gabi200/canary-firmware/RPISoftware/README.md

# Canary 🐤

**Smart Building Safety & Hazard-Response Platform** for multi-unit residential buildings
(Romanian HOA / *asociații de proprietari* context).

Canary connects to an in-building IoT sensor network (combustible gas, CO, smoke /
particulates, water leak, and presence: radar on the real air sensor, Wi-Fi in the legacy
demo) and drives the safety-critical path:

> **detection → alert → evacuation → victim-accounting**

This directory is the **Raspberry Pi hub**: it receives MQTT from the real Canary
sensors (`../air_sensor` ESP32-S3, `../water_sensor` ESP32-C3), stores and analyses it,
and serves the web dashboard and the mobile app. It runs with one command
(`docker compose up -d`) on 64-bit Raspberry Pi OS, and simulators stand in for the
hardware when there is none. The architecture and delivery plan is
**[`ARCHITECTURE.md`](./ARCHITECTURE.md)**; its "As built" section says which parts of the
plan this hub implements. The firmware ↔ hub contract (MQTT topics, status documents,
analysis vocabulary, API) is **[`docs/HARDWARE.md`](./docs/HARDWARE.md)**. Checks and
troubleshooting: **[`DEBUG.md`](./DEBUG.md)**.

```
ESP32 air / water ──MQTT──▶ Mosquitto ──▶ backend (FastAPI)
  (per-device login)          (Pi)          ├─ raw status history + canonical readings
                                            ├─ detection → incidents → evacuation → accounting
                                            ├─ analysis per node / zone / building
                                            └─ REST + WebSocket
                            web dashboard ◀─┤  raw + analysis   (nginx, port 80)
                            mobile app    ◀─┘  analysis only    (port 80 or 8000)
```

---

## What's built

```
docker-compose.yml      mosquitto + backend + web (+ simulators in the "sim" profile); Pi-ready (arm64);
                        profile "cluster" adds etcd + Patroni Postgres + keepalived for the three-Pi mode
cluster/                three-Pi mode images (Patroni, keepalived) and the hailo-ollama unit for the AI HAT+ 2
mosquitto/config/       broker config: auth required, persistence, logs to stdout
                        (the password file is generated by scripts/pi_setup.sh, never committed)
scripts/pi_setup.sh     one-time setup: .env secrets, MQTT users per sensor, portal values to type
scripts/smoke.sh        backend tests + web typecheck/build + static infra checks (no Docker needed)
backend/                FastAPI service (SQLite on a volume by default, Postgres optional; no Redis)
  app/
    enums.py            canonical wire/DB/API vocabularies (single source of truth)
    config.py           env config (CANARY_*, docs/HARDWARE.md section 6)
    db.py               async SQLAlchemy; SQLite (WAL), or Postgres (+ Timescale hypertables if installed)
    models.py           data model (ARCHITECTURE.md §6) + hardware nodes / raw status history
    schemas.py          wire contracts (hardware status documents, canary.telemetry.v1) + API DTOs
    detection/          pure threshold + decision engine (§B, §7 guards)
    incidents/          pure state machine + orchestration service (§7)
    occupancy/          occupancy estimate + victim-accounting (§B)
    analytics/          node/zone/building analysis, triangulation, false-alarm reduction
    notify/             notification fan-out (stub: persists + WebSocket broadcast)
    ingestion/          pipeline, MQTT consumer, hardware status documents (hardware.py) (§5)
    retention.py        hourly: prunes raw status, readings, occupancy older than CANARY_RETENTION_DAYS
    realtime/           WebSocket connection manager (per-building rooms, time-boxed sends)
    api/                REST + WebSocket routes (§A.5)
    security.py         JWT auth + RBAC
    seed.py             demo building bld_007 (sensors, users, ARC)
    cluster.py          three-Pi mode: heartbeats, the processing lease, node-to-node calls
    ai/                 AI tasks (triangulation, signature shadow model, incident brief) and their offload
    main.py             app wiring + lifespan; keeps ?token= JWTs out of uvicorn's logs
  tests/                pure-logic + API/flow tests (95)
  Dockerfile            python:3.12-slim, deps from pyproject.toml, runs unprivileged
web/                    React + TS operations dashboard (raw + analysis)
  Dockerfile, nginx.conf  Vite build served by nginx, which proxies /api (+ WebSocket), /health, /docs
mobile/                 Flutter resident app (analysis only)
simulator/
  hw_sim.py             firmware-accurate air + water nodes (status documents, retained, last will, heartbeats)
  simulate.py           legacy canary.telemetry.v1 sensors of the demo building
docs/HARDWARE.md        the firmware ↔ hub contract
```

## Quickstart: Raspberry Pi (or any Docker host)

Full walk-through, including installing Docker and provisioning the ESP32 portals, in
**[`RUNME.md`](./RUNME.md) section 1**.

```bash
cd RPISoftware
scripts/pi_setup.sh air-kitchen water-kitchen   # .env secrets + one MQTT user per sensor;
                                                # prints what to type into each sensor's portal
docker compose up -d --build                    # Mosquitto :1883, backend :8000, dashboard :80
open http://<pi-ip>/                            # sign in as mihai

# no hardware? firmware-accurate simulated sensors:
docker compose --profile sim run --rm hw-sim --scenario co --fast
#   scenarios: normal | co | gas | smoke | leak | presence | offline | reboot | all
```

Watch live incidents over WebSocket (get a token first):

```bash
TOKEN=$(curl -s localhost:8000/api/v1/auth/token -H 'content-type: application/json' \
  -d '{"username":"mihai"}' | python3 -c 'import sys,json;print(json.load(sys.stdin)["access_token"])')

# any WS client, e.g. websocat:
websocat "ws://localhost:8000/api/v1/ws/incidents?building_id=bld_007&token=$TOKEN"
```

## One Pi or three

`CANARY_CLUSTER_MODE=single` (default) runs everything on one Pi, as above. `triple` spreads the
hub over three Pis that cover for each other (**[`RUNME.md`](./RUNME.md) section 3**):

| Pi | Runs | If it fails |
|---|---|---|
| `web` | the hub address (a floating IP): MQTT broker for the sensors, dashboard, API for the app | the address moves to `processing`, then `ai` |
| `processing` | MQTT subscription, detection, incidents, notifications, retention | `web` takes it over, then `ai` |
| `ai` | triangulation, the signature shadow model and incident briefs, the briefs on a Raspberry Pi AI HAT+ 2 (Hailo-10H, hailo-ollama) | the caller computes itself; briefs fall back to a template |

The three share one Postgres (Patroni: a primary and two replicas, one synchronous) and any one Pi
can fail; with two down the hub stops (no quorum) while the sensors keep alarming on their own.
`/admin/hub` in the dashboard shows which Pi runs what.

```bash
scripts/pi_setup.sh --cluster 192.168.1.10 192.168.1.11 192.168.1.12 192.168.1.13   # VIP, processing, web, ai
# copy .env and mosquitto/config/passwd to the other two Pis, run scripts/pi_setup.sh there, then on all three:
docker compose up -d --build
```

## Quickstart (no Docker — SQLite + HTTP ingest)

```bash
cd backend
python3 -m venv .venv && . .venv/bin/activate
pip install -e ".[dev]"
export CANARY_DATABASE_URL="sqlite+aiosqlite:///./canary.db"
export CANARY_MQTT_ENABLED=false
uvicorn app.main:app --reload
# then POST telemetry to /api/v1/telemetry (same pipeline as MQTT) — see tests for payloads
```

## Demo accounts (seeded, dev token by username)

| username | role | can |
|---|---|---|
| `ana` | resident | check in ("I'm safe"), see status |
| `mihai` | hoa_manager | dashboard, incidents, accounting, dismiss/evacuate/resolve |
| `dispecer` | dispatcher_external | incident-centric view, accounting |
| `tehnician` | technician | installs: floors, apartments, rooms, new sensors, alarm tests (no accounts, no incident actions) |
| `admin` | system_admin | everything |

The login is username-only: a known MVP limitation. Run the hub on a trusted LAN/VLAN
(RUNME §1.10).

## Key endpoints

| Method | Path | Role |
|---|---|---|
| POST | `/api/v1/auth/token` | public (dev) |
| GET | `/api/v1/buildings/{id}/summary` | any (analysis only: mobile + dashboard; residents get no occupancy) |
| GET | `/api/v1/buildings/{id}/nodes` | manager / dispatcher / admin (raw + analysis) |
| GET | `/api/v1/nodes/{node_id}/history?minutes=60&fields=a,b` | manager / dispatcher / admin |
| PATCH | `/api/v1/nodes/{node_id}` (`zone_id`, `name`) | manager / admin |
| GET | `/api/v1/buildings/{id}/incidents?active=true` | any |
| GET | `/api/v1/incidents/{id}/events` | any |
| GET | `/api/v1/incidents/{id}/accounting` | manager / dispatcher |
| GET | `/api/v1/incidents/{id}/brief` | manager / dispatcher (short responder brief: AI HAT+ 2 LLM, else a template) |
| GET | `/api/v1/cluster` | manager / technician / admin (which Pi runs what) |
| POST | `/api/v1/incidents/{id}/checkin` | resident |
| POST | `/api/v1/incidents/{id}/dismiss` \| `/order-evacuation` \| `/resolve` | manager / dispatcher |
| POST | `/api/v1/telemetry` | dev ingress, no auth (prod = MQTT) |
| WS | `/api/v1/ws/incidents?building_id=&token=` | authenticated |

`system_admin` passes every role check. REST timestamps are UTC with a `Z` suffix.
Payload shapes of the hardware endpoints: [`docs/HARDWARE.md`](./docs/HARDWARE.md) sections 3–5.
The safety rules applied to hardware readings (device thresholds only when sane, a
device's own alarm never downgraded, only the reporting device can clear its incident,
smoke never auto-evacuates) are in its section 2.

## Tests

```bash
bash scripts/smoke.sh                        # backend tests + web typecheck/build + static infra checks: SMOKE: PASS
cd backend && .venv/bin/python -m pytest -q  # 95 passed (smoke.sh creates .venv on its first run)
```

- `test_state_machine.py`, `test_detection.py` — pure logic, no DB (incl. insane device thresholds → defaults).
- `test_ingestion_dedupe.py` — `(device_id, epoch, seq)` dedupe + **reboot regression**.
- `test_incident_flow.py` — critical gas → `evacuation`, check-in → unaccounted count drops, RBAC,
  another device's normal readings never clear an incident, UTC timestamps on SQLite.
- `test_hardware_translation.py`, `test_environment_analysis.py` — status document → readings,
  and the analysis vocabulary (pure).
- `test_hardware_ingest.py` — the MQTT hardware path end to end: registration, retained/duplicate
  documents, reboots, availability, resident privacy, roles, history, retention, WebSocket
  fan-out, log redaction.

Mobile: `flutter analyze` and `flutter test` in `mobile/` ([`mobile/README.md`](./mobile/README.md)).

Agent-oriented checks and troubleshooting (including MQTT): [`DEBUG.md`](./DEBUG.md).

## Web — Operations dashboard (React)

`web/` — role-based console (React + TS + Vite): **Manager/HOA** view (floor plan, live
sensor status, an Environment card for the hardware nodes, trends, device health, incident
actions), **Dispatch/emergency-services** view (hazard source on floor plan, occupancy +
unaccounted count, evacuation progress, timeline) and **Sensors** view (`/sensors`: the
hub's analysis on top, then each ESP32 with its raw status grouped like the firmware, its
own thresholds, the verbatim JSON and raw history charts, 15 min–24 h). Live over
WebSocket. On the hub it is served by nginx on port 80, same origin as the API. See
[`web/README.md`](./web/README.md).

## Mobile — Flutter resident app

`mobile/` — resident app (Flutter): emergency alerts, evacuation guidance routed away
from the hazard, and "I'm safe" check-in feeding victim-accounting. Talks to the hub
over REST + WebSocket (`--dart-define=CANARY_API=http://<pi-ip>`) and shows the sensor
analysis only ("Home status" for residents, "Building sensors" for managers), never raw
sensor values. See [`mobile/README.md`](./mobile/README.md).

## AI hazard-source triangulation

`backend/app/analytics/` — estimates the leak origin from the sensor array
(concentration-weighted centroid + time-of-first-detection, optional airflow prior),
with an honest confidence score (capped at 0.95; single-sensor degrades to zone-level).
Runs from `verification` onward for gas/CO; exposed at
`GET /api/v1/incidents/{id}/triangulation` and surfaced on the dashboard floor plan
(SOURCE marker + confidence) and the Dispatch "Hazard source (AI)" card. The estimate
can differ from the first-detection zone (it follows the concentration peak).

## False-alarm reduction

`backend/app/analytics/false_alarm.py` — classifies a sensor's recent reading window
(spike-and-decay, oscillatory cooking, sensor drift, sustained-genuine, sub-threshold
micro-leak trend) and may **hold a corroborated-by-count, non-critical signal in
`verification`** instead of alarming — e.g. a lone sensor sitting flat just over
threshold. Real cross-sensor corroboration (a second device/zone) or a clearly rising
trend escalates as genuine. **Critical readings and edge alarms are never suppressed.**
Slow sub-threshold rises open a low-severity **advisory** incident (managers only).
Assessment shown on the dashboard (signal badge); rule-based now, same features feed
an ML upgrade later (ARCHITECTURE.md §B.3).

Air nodes are also labelled by the hazard signature classifier
(`backend/app/analytics/signature/`), which reads all of a node's channels together. A
confident steam, cooking or aerosol label may hold a corroborated **particulate**
escalation from a single sensor in `verification` (reason `held_signature_<label>`); a
fire label cancels any hold. Gas and CO, critical readings, node alarms and real
cross-sensor corroboration are never held by it. A shadow model's opinion is stored in
`signature_assessments` but never used.

## Known limitations

- Not yet validated on a physical Raspberry Pi with the real sensors: tests and the
  firmware-accurate simulator only.
- Username-only dashboard/app login and plaintext MQTT/HTTP: trusted LAN/VLAN only
  (RUNME §1.10).
- The demo building `bld_007` (zones, demo devices, users) is always seeded, and new
  sensors with a `demo-` MQTT base land in its `zone_hallway`; every other new sensor lands in
  `bld_live` / `zone_live`, until moved (`PATCH /api/v1/nodes/{id}`).
- One open incident per hazard type per building.
- The hub sends no commands to the devices yet (the firmware's valve/buzzer topics exist).
- No schema migrations: a Postgres database created by an earlier version needs one
  manual change (RUNME §1.9).

## Not yet built (see ARCHITECTURE.md roadmap §F)

TLS for MQTT/HTTP and real user authentication, real FCM/APNs delivery (wired but off
by default; needs Firebase config), hub → device commands, LoRa gateway tier,
tamper-evident audit hash-chaining, alembic migrations, external dispatch adapters. The
backend notification layer is a stub (persists + WebSocket broadcast); transports plug
in behind it. Occupancy/victim-accounting is basic (rule-based) — the ML upgrade paths
are described in ARCHITECTURE.md §B. What was built versus the plan: the "As built"
section at the top of [`ARCHITECTURE.md`](./ARCHITECTURE.md).

> ⚠️ MVP detection thresholds are illustrative engineering defaults, **not** certified
> life-safety setpoints. Canary is an advisory system in this slice — not a substitute
> for certified gas/CO alarms.
