gabi200/canary-firmware/HANDOFF.md

# Handoff: Evacuate screen redesign

Branch: `feat/evacuate-route-line` · Last updated: 2026-09-30

## Done

- **Backend.** `GET /buildings/{id}/evacuation` returns `waypoints` (`id`, `label`, `kind`, `hint`)
  with human-readable names, skips malformed path entries instead of failing, and orders
  routes deterministically. The seed route uses real Romanian names and hints.
  101 tests pass.
- **Mobile, Evacuate screen (model A, "route line").** `lib/src/ui/alarm_screen.dart`,
  `widgets/route_line.dart`:
  - hazard header with a Live/Offline chip; Minimize replaces the ✕
  - a "don't" line per hazard type (`logic/hazard_advice.dart`)
  - vertical route: Start here → steps with hints → assembly point, plus an "Avoid: <zone>" marker
  - a pinned action bar: I'm out and safe / I need help / Call 112 (`url_launcher`) /
    Safe but still inside; the check-in can be changed later
  - haptic pulse on open; the screen stays awake (`wakelock_plus`)
- **Mobile, route safety.** `logic/route_selection.dart` rates each route `clear`, `unknown` or
  `crosses` against every affected zone. The screen shows a red warning for `crosses` and an
  amber one for `unknown`. Parsing skips malformed routes and waypoints instead of dropping
  everything. 21 tests pass; `flutter analyze` reports no errors or warnings.
- Verified by hand on the Pixel 9 Pro XL emulator with a simulated gas leak.

## To do next

1. Widget tests and golden screenshots for the Evacuate screen: each hazard type,
   `crosses` / `unknown` warnings, offline chip, check-in → Change flow, 2× text scale.
2. Home screen shows raw IDs: `bld_007` in the app bar and `zone_kitchen` in the red
   EVACUATE banner (`home_screen.dart`, `flashing_evacuate_banner.dart`). Use the building
   name and `zoneLabelsProvider`. Sweep `lib/src/ui` for other raw IDs and literal colors.
3. Romanian localization (`flutter_localizations` + ARB files) with diacritics. The UI is
   English while the building data is Romanian.
4. Freshness chip: the incident controller sets `connected` when a WebSocket attempt
   *starts*, so "Live" can show before the socket is up. Set it on the first message or
   ack, and show "Updated N s ago".
5. Cache the last evacuation info locally so the route still shows offline
   ("Offline · showing saved route").
6. Optional read-aloud of the next step (TTS).
7. Floor-plan view (model C) as a "See on floor plan" toggle above the route line.
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
