gabi200/canary-firmware/RPISoftware/mobile/assets/signs/P020.png

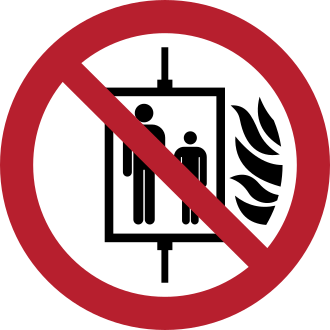
RPISoftware/mobile/assets/signs/P020.png
