gabi200/canary-firmware/RPISoftware/mobile/assets/signs/P031.png

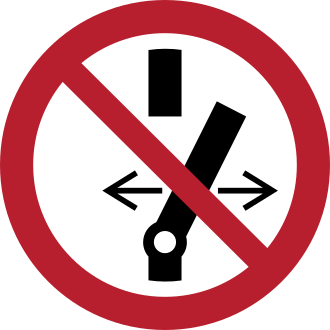
RPISoftware/mobile/assets/signs/P031.png
