gabi200/canary-firmware/cad/esp32c3.SLDPRT

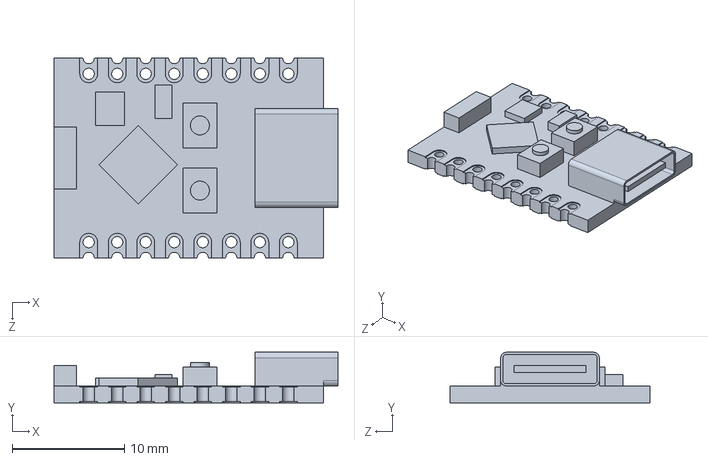
[picture p3: CAD file, 2026-10-17]
cad/esp32c3.SLDPRT
25.3 x 4.50 x 17.8 mm
