gabi200/canary-firmware/cad/ESP32-S3-WROOM-1.SLDPRT

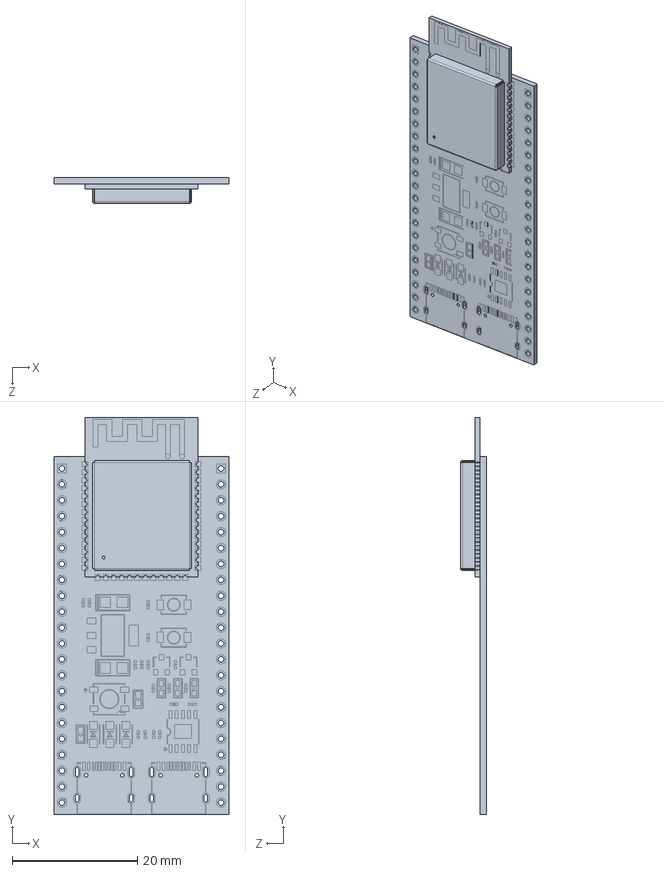
[picture p4: CAD file, 2026-10-17]
cad/ESP32-S3-WROOM-1.SLDPRT
27.9 x 63.4 x 4.11 mm
