gabi200/canary-firmware/cad/Water_sensor.SLDASM

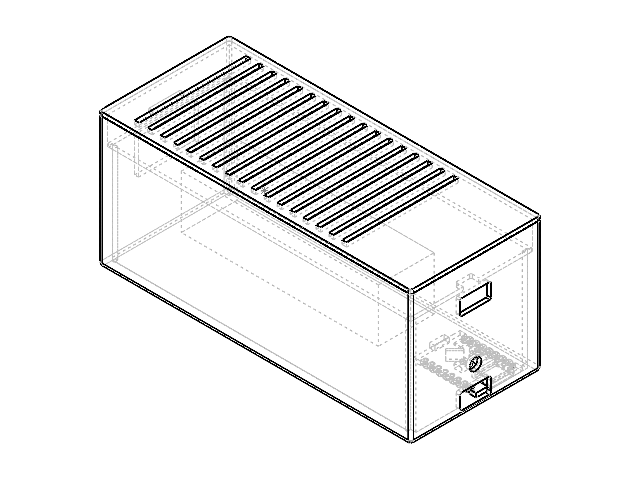
[picture p5: CAD file, 2026-10-28]
cad/Water_sensor.SLDASM
Main_body^Water_sensor
Top_cover^Water_sensor
Water_shield^Water_sensor
esp32c3
18650_bat_placeholder^Water_sensor
