gabi200/canary-firmware/cad/Air_sensor.SLDASM

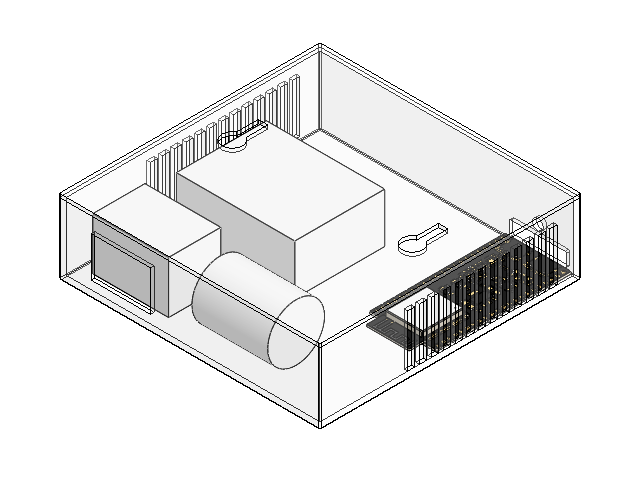
[picture p6: CAD file, 2026-10-17]
cad/Air_sensor.SLDASM
Main_body^Air_sensor
ESP32-S3-WROOM-1
Top_cover^Air_sensor
CO_sensor^Air_sensor
Gas_sensor^Air_sensor
PM_sensor^Air_sensor
