gabi200/canary-firmware/(list of files, cad)

Other CAD files:
air_sensor/test_main.obj
air_sensor/config_store_fallback_test.obj
air_sensor/reader_frames_test.obj
air_sensor/DeviceConfig.obj
air_sensor/MqttService.obj
air_sensor/Pms5003Reader.obj
air_sensor/Ze03Reader.obj
air_sensor/AirController.obj
air_sensor/Auth.obj
air_sensor/Ld2410Reader.obj
air_sensor/MqttServiceTestStubs.obj
air_sensor/ConfigStore.obj
