gabi200/canary-firmware/water_sensor/water_sensor.ino

#include "ConfigStore.h"
#include "DeviceConfig.h"
#include "HardwareConfig.h"
#include "HttpApi.h"
#include "LeakController.h"
#include "MeshLink.h"
#include "MqttService.h"
#include "NetworkConfig.h"
#include "PersistenceRetry.h"

#include <Arduino.h>
#include <WiFi.h>

#include <memory>

namespace {

std::unique_ptr<ConfigStore> configStore;
std::unique_ptr<LeakController> controller;
std::unique_ptr<NetworkConfig> networkConfig;
std::unique_ptr<HttpApi> httpApi;
std::unique_ptr<MqttService> mqttService;
std::unique_ptr<MeshLink> meshLink;
DeviceConfig deviceConfig{};
DeviceConfig pendingDeviceConfig{};
uint32_t lastSampleMs = 0;
uint32_t sampleSum = 0;
uint8_t sampleCount = 0;
uint16_t latestAdc = 0;
PersistenceRetry pendingPersistence;
bool configSavePending = false;
bool configSaveImmediate = false;
uint32_t lastConfigSaveAttemptMs = 0;
bool configRebootPending = false;
bool closeStateSavedForReboot = false;
bool rebootScheduled = false;
uint32_t rebootScheduledAtMs = 0;
bool networkServicesStarted = false;
uint32_t lastDebugHeartbeatMs = 0;

constexpr uint32_t DEBUG_HEARTBEAT_MS = 5000;

RuntimeStatus runtimeStatus() {
  const bool wifiConnected = networkConfig && networkConfig->wifiConnected();
  return RuntimeStatus{
      millis(),
      latestAdc,
      wifiConnected,
      wifiConnected ? networkConfig->wifiRssi() : 0,
      mqttService && mqttService->connected(),
      httpApi && httpApi->otaInProgress(),
      wifiConnected ? networkConfig->wifiIp() : 0,
  };
}

void notifyStateChanged() {
  if (mqttService) {
    mqttService->requestStatusPublish();
  }
}

void applyValveOutput() {
  const bool valveClosed = !controller || controller->valveState() == ValveState::Closed;
  digitalWrite(Hardware::RELAY_PIN,
               Hardware::outputLevel(valveClosed, Hardware::RELAY_ACTIVE_HIGH));
}

void applyBuzzerOutput(uint32_t nowMs) {
  const bool buzzerActive = controller && controller->buzzerOutput(nowMs);
  digitalWrite(Hardware::BUZZER_PIN,
               Hardware::outputLevel(buzzerActive, Hardware::BUZZER_ACTIVE_HIGH));
}

void applyOutputs(uint32_t nowMs) {
  applyValveOutput();
  applyBuzzerOutput(nowMs);
}

void sampleSensor(uint32_t nowMs) {
  if (static_cast<uint32_t>(nowMs - lastSampleMs) <
      Hardware::SENSOR_SAMPLE_INTERVAL_MS) {
    return;
  }
  lastSampleMs = nowMs;
  sampleSum += analogRead(Hardware::SENSOR_ADC_PIN);
  if (++sampleCount == Hardware::SENSOR_AVERAGE_SAMPLES) {
    latestAdc = static_cast<uint16_t>(sampleSum / sampleCount);
    if (controller->updateSensor(latestAdc, nowMs)) {
      notifyStateChanged();
    }
    sampleSum = 0;
    sampleCount = 0;
  }
}

bool elapsed(uint32_t nowMs, uint32_t sinceMs, uint32_t intervalMs) {
  return static_cast<uint32_t>(nowMs - sinceMs) >= intervalMs;
}

void queueConfigurationSave(const DeviceConfig& config, uint32_t nowMs) {
  pendingDeviceConfig = config;
  configSavePending = true;
  configSaveImmediate = true;
  configRebootPending = true;
  closeStateSavedForReboot = false;
  rebootScheduled = false;

  controller->requestValve(ValveState::Closed, nowMs);
  pendingPersistence.update(controller->persistentState());
  applyOutputs(nowMs);
}

void collectControllerPersistence() {
  if (!controller->takePersistentDirty()) {
    return;
  }
  pendingPersistence.update(controller->persistentState());
  if (configRebootPending) {
    closeStateSavedForReboot = false;
    rebootScheduled = false;
  }
}

void processConfigurationSave(uint32_t nowMs) {
  if (!configSavePending ||
      (!configSaveImmediate &&
       !elapsed(nowMs, lastConfigSaveAttemptMs,
                PersistenceRetry::RETRY_INTERVAL_MS))) {
    return;
  }

  if (configStore->saveConfig(pendingDeviceConfig)) {
    deviceConfig = pendingDeviceConfig;
    configSavePending = false;
    configSaveImmediate = false;
    return;
  }

  configSaveImmediate = false;
  lastConfigSaveAttemptMs = nowMs;
}

void processStateSave(uint32_t nowMs) {
  if (!pendingPersistence.due(nowMs)) {
    return;
  }

  const PersistentState attemptedState = pendingPersistence.state();
  const bool saved = configStore->saveState(attemptedState);
  pendingPersistence.recordResult(saved, nowMs);
  if (configRebootPending) {
    closeStateSavedForReboot =
        saved && attemptedState.requestedValve == ValveState::Closed;
    if (!saved) {
      rebootScheduled = false;
    }
  }
}

void updateRebootSchedule(uint32_t nowMs) {
  if (!configRebootPending || configSavePending ||
      !closeStateSavedForReboot || rebootScheduled) {
    return;
  }
  rebootScheduled = true;
  rebootScheduledAtMs = nowMs;
}

void restartWhenSafe(uint32_t nowMs) {
  if (!rebootScheduled || configSavePending ||
      !closeStateSavedForReboot ||
      !elapsed(nowMs, rebootScheduledAtMs, 500)) {
    return;
  }

  controller->requestValve(ValveState::Closed, nowMs);
  if (controller->takePersistentDirty()) {
    pendingPersistence.update(controller->persistentState());
    closeStateSavedForReboot = false;
    rebootScheduled = false;
    return;
  }
  applyOutputs(nowMs);
  ESP.restart();
}

}  // namespace

void setup() {
  digitalWrite(Hardware::RELAY_PIN,
               Hardware::outputLevel(true, Hardware::RELAY_ACTIVE_HIGH));
  pinMode(Hardware::RELAY_PIN, OUTPUT);
  digitalWrite(Hardware::BUZZER_PIN,
               Hardware::outputLevel(false, Hardware::BUZZER_ACTIVE_HIGH));
  pinMode(Hardware::BUZZER_PIN, OUTPUT);
  digitalWrite(Hardware::BUZZER_PIN,
               Hardware::outputLevel(true, Hardware::BUZZER_ACTIVE_HIGH));
  delay(Hardware::STARTUP_BEEP_MS);
  digitalWrite(Hardware::BUZZER_PIN,
               Hardware::outputLevel(false, Hardware::BUZZER_ACTIVE_HIGH));
  pinMode(Hardware::CONFIG_BUTTON_PIN, INPUT_PULLUP);

  Serial.begin(115200);
  delay(250);
  Serial.println();
  Serial.printf("[boot] water-sensor firmware %s\n", Hardware::FIRMWARE_VERSION);
  Serial.println("[boot] serial ready at 115200 baud");

  configStore = std::make_unique<ConfigStore>();
  configStore->begin();
  deviceConfig = configStore->loadConfig();
  const ConfigValidation configValidation = validateDeviceConfig(deviceConfig);
  Serial.printf("[boot] configuration %s\n",
                configValidation.valid ? "valid" : "requires provisioning");

  const LeakConfig leakConfig{
      deviceConfig.wetThreshold,
      deviceConfig.dryThreshold,
      deviceConfig.debounceMs,
      deviceConfig.alarmDurationSeconds * 1000UL,
      Hardware::BUZZER_BEEP_ON_MS,
      Hardware::BUZZER_BEEP_OFF_MS,
  };
  controller = std::make_unique<LeakController>(leakConfig);
  controller->restore(configStore->loadState(), millis());
  analogReadResolution(12);
  pinMode(Hardware::SENSOR_ADC_PIN, INPUT);
  applyOutputs(millis());

  const int configButtonLevel = digitalRead(Hardware::CONFIG_BUTTON_PIN);
  const bool forcePortal = Hardware::CONFIG_BUTTON_ACTIVE_LOW
                               ? configButtonLevel == LOW
                               : configButtonLevel == HIGH;
  Serial.printf("[boot] config button level=%d force_portal=%s\n",
                configButtonLevel, forcePortal ? "yes" : "no");
  networkConfig = std::make_unique<NetworkConfig>();
  networkConfig->begin(deviceConfig, forcePortal);
  httpApi = std::make_unique<HttpApi>(deviceConfig, *controller, *configStore,
                                      runtimeStatus, notifyStateChanged);
  meshLink = std::make_unique<MeshLink>();
  meshLink->begin();
  mqttService = std::make_unique<MqttService>(deviceConfig, *controller,
                                              *configStore, runtimeStatus,
                                              *meshLink);
  Serial.println("[boot] setup complete; valve starts closed");
}

void loop() {
  const uint32_t nowMs = millis();
  sampleSensor(nowMs);
  if (controller->tick(nowMs)) {
    notifyStateChanged();
  }
  applyOutputs(nowMs);

  networkConfig->process();
  if (!networkServicesStarted && networkConfig->servicesReady()) {
    Serial.println("[services] starting HTTP and MQTT");
    httpApi->begin();
    mqttService->begin();
    networkServicesStarted = true;
    Serial.println("[services] startup complete");
  }
  if (networkServicesStarted) {
    httpApi->handleClient();
  }
  const uint32_t persistenceNowMs = millis();
  DeviceConfig changedConfig{};
  if (networkConfig->takeConfigChanged(changedConfig)) {
    queueConfigurationSave(changedConfig, persistenceNowMs);
  }

  if (networkServicesStarted) {
    mqttService->process(persistenceNowMs);
  }
  // MQTT commands are applied above by the safety-loop owner; reflect a
  // commanded closure/opening before persistence and without waiting for the
  // next pass through loop().
  applyOutputs(persistenceNowMs);
  collectControllerPersistence();
  processConfigurationSave(persistenceNowMs);
  processStateSave(persistenceNowMs);
  updateRebootSchedule(persistenceNowMs);
  restartWhenSafe(millis());

  if (httpApi->rebootDue(millis())) {
    controller->requestValve(ValveState::Closed, millis());
    applyOutputs(millis());
    ESP.restart();
  }

  if (elapsed(nowMs, lastDebugHeartbeatMs, DEBUG_HEARTBEAT_MS)) {
    lastDebugHeartbeatMs = nowMs;
    Serial.printf(
        "[status] uptime=%lu adc=%u wifi=%s portal=%s services=%s heap=%lu\n",
        static_cast<unsigned long>(nowMs), static_cast<unsigned>(latestAdc),
        networkConfig->wifiConnected() ? "connected" : "disconnected",
        networkConfig->portalActive() ? "active" : "inactive",
        networkServicesStarted ? "running" : "waiting",
        static_cast<unsigned long>(ESP.getFreeHeap()));
  }

  delay(1);
}
