gabi200/canary-firmware/air_sensor/PortalSubmissionPolicy.h

#pragma once

#include <stdint.h>

enum class PortalSubmissionAction : uint8_t {
  PublishConfig,
  ClearCredentialsAndRestart,
  RestoreCredentialsAndRestart,
};

class PortalSubmissionPolicy {
 public:
  explicit PortalSubmissionPolicy(bool hasValidConfig)
      : hasValidConfig_(hasValidConfig), publishPending_(false) {}

  bool shouldForcePortal(bool explicitlyForced) const {
    return explicitlyForced || !hasValidConfig_;
  }

  PortalSubmissionAction evaluate(bool submissionValid) {
    if (submissionValid) {
      hasValidConfig_ = true;
      publishPending_ = true;
      return PortalSubmissionAction::PublishConfig;
    }
    publishPending_ = false;
    return hasValidConfig_
               ? PortalSubmissionAction::RestoreCredentialsAndRestart
               : PortalSubmissionAction::ClearCredentialsAndRestart;
  }

  // Call after WiFiManager::process() has returned from the save that was
  // accepted. Wi-Fi need not be connected: a parameters-only save never
  // reconnects, and the restart that applies the settings reconnects anyway.
  bool takePublishReady() {
    if (!publishPending_) {
      return false;
    }
    publishPending_ = false;
    return true;
  }

 private:
  bool hasValidConfig_;
  bool publishPending_;
};
