gabi200/canary-firmware/(commit log)

2026-09-05 Initialize Canary firmware repository with ESP32-C3 water sensor
2026-09-23 Add RPISoftware hub MVP as it was before the hardware integration
    Imports the previously untracked Raspberry Pi hub software unchanged:
    FastAPI backend (detection, incidents, triangulation, false-alarm
    reduction), legacy canary.telemetry.v1 simulator, React operations
    dashboard and Flutter resident app. The next commit shows exactly what
    the MQTT integration with the real air/water sensors changed.
    Claude-Session: https://claude.ai/code/session_01Xwfvu6dca7FK2ikvKfmBmq
    [Deviz_estimativ_TeCHALLENGE_actualizat.xlsx]
2026-09-23 Integrate real ESP32 air/water sensors into the Pi hub over MQTT
    The hub now consumes the firmware's own MQTT topics (<base>/status and
    <base>/availability) from both sensors, centralizes the data on the Pi,
    and serves raw + analyzed data to the web dashboard and analysis-only
    data to the mobile app. docs/HARDWARE.md is the firmware <-> hub contract.
    Backend
    - Auto-register each ESP32 as a node, keep every raw status document,
    translate channels into canonical readings for the existing incident
    engine, graded with the device's own (sanity-checked) thresholds.
    - Analysis layer: EPA AQI, CO/gas levels, comfort, occupancy, leak and
    valve state, health (offline/stale/warm-up/Wi-Fi), trend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
2026-09-29 Advertise sensors over mDNS instead of relying on fixed IPs
    Both sensors now register <device-name>.local and a _canary._tcp service
    (TXT: type, fw, api) once Wi-Fi is up, and send the same name as their DHCP
    hostname, so clients can reach or discover them after an address change.
    Air sensor:
    - Holding the config button (GPIO0) for 3 s at any time restarts into the
    setup portal; the old sub-second window just after boot was impractical.
    - Log portal saves (token length only), validation failures and config
    persistence to the USB console.
    Docs:
    - Air sensor LED pins now match the firmware (GPIO21/47/48).
    - curl OTA examples pass -H 'Expect:' so curl does not stall past the
    device's 1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
    [HardwareConfig.h, Hostname.h, NetworkConfig.cpp, NetworkConfig.h, air_sensor.ino, test_main.cpp]
2026-09-29 Air sensor: store portal settings without waiting for Wi-Fi
    A portal save that did not pick a Wi-Fi network never reconnected, so the
    accepted settings waited forever for WL_CONNECTED, the sensor stayed off the
    network and a restart discarded them (e.g. a new MQTT host). Publish them
    once WiFiManager::process() has returned from the save, as the water sensor
    does; the restart that applies them reconnects with the stored credentials.
    Also log MQTT connect results (host, resolved address, port, user, PubSubClient
    state; never the password) to the USB console.
    [MqttService.cpp, NetworkConfig.cpp, PortalSubmissionPolicy.h, test_main.cpp]
2026-09-30 added cad
    [Water_sensor.SLDASM]
2026-09-30 cad update
    [Water_sensor.SLDASM, esp32c3.SLDPRT]
2026-09-30 Redesign the resident Evacuate screen as a route line
    Replace the horizontal schematic with a vertical route line that uses
    readable waypoint names and hints, a hazard-specific "don't" line, and a
    pinned action bar (safe / need help / Call 112, changeable check-in).
    Backend: the evacuation endpoint returns resolved waypoints, skips
    malformed path entries, and orders routes deterministically.
    Mobile: route selection rates each route clear / unknown / crosses
    against every affected zone and never presents an unchecked route as
    safe; parsing tolerates malformed hub data.
    Also adds AGENTS.md, Codex agent roles, and HANDOFF.md with next steps.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
2026-10-05 update cad
    [Air_sensor.SLDASM, ESP32-S3-WROOM-1.SLDPRT, Water_sensor.SLDASM]
2026-10-05 finish cad
    [Air_sensor.SLDASM]
2026-10-09 Scope the benign signature hold to single-sensor particulate escalations
    A confident steam/cooking/aerosol signature held any corroborated escalation,
    including a combustible gas or CO incident and particulate corroborated by a
    second device or zone. The hold now applies only to particulate without
    cross-sensor corroboration; the fire override still cancels any hold.
2026-10-13 Remove the pre-integration sensor prototypes
    The iot-sensors sketches predate the real air_sensor and water_sensor
    firmware and publish a payload shape the hub ignores.
2026-10-13 Run the hub on one Raspberry Pi or three redundant ones
    CANARY_CLUSTER_MODE=single keeps today's hub. In triple mode three Pis
    share a Patroni Postgres and each runs the backend:
    - app/cluster.py: heartbeats in cluster_nodes and a processing lease in
    cluster_leases, both on the database clock. The holder runs the MQTT
    subscription, retention and escalation resume; it fences itself when
    it cannot renew, and the home Pi takes the role back once settled.
    - WebSocket events are forwarded to the other Pis with retries, since
    dashboards and phones connect to whichever Pi holds the hub address.
    - app/ai: triangulation, the signature shadow model and a new incident
    brief run on the AI Pi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
2026-10-13 Add the three-Pi stack: etcd, Patroni, pgproxy and keepalived
    Profile "cluster" (set through .env) adds per Pi: etcd, Postgres under
    Patroni (synchronous standby, pg_rewind), HAProxy routing the backend to
    the current primary, and keepalived moving the hub's floating address.
    scripts/pi_setup.sh --cluster writes the shared settings; on each Pi it
    detects the role from the Pi's address. cluster/hailo-ollama.service runs
    the LLM server on the AI Pi's AI HAT+ 2.
    [haproxy.cfg]
2026-10-13 Show the Pis' roles and write incident briefs in the dashboard
    Administration gets a Hub tab (which Pi runs what, failovers, the AI
    HAT+ 2), managers see a banner when a Pi is down, and the Dispatch view
    generates incident briefs. nginx allows the brief's longer answer time,
    and the live socket pings so it notices when the hub address moves.
2026-10-13 Ping the app's live socket so it notices a moved hub address
2026-10-13 Document the three-Pi mode and the AI HAT+ 2 incident brief
    RUNME section 3 covers setup, failover times measured in a drill on
    three simulated Pis, a failover drill and going back to one Pi.
2026-10-23 Relay sensor status over ESP-NOW when a node loses MQTT
    A water or air node that loses its MQTT session (usually its Wi-Fi) keeps
    sending its status document over ESP-NOW on every change and heartbeat.
    Every node listens: one with a live MQTT session republishes the frame on
    the origin's <base>/status, one without rebroadcasts it (up to 3 hops).
    The hub needs no change, since the broker has no ACLs and a live status
    marks the node online again.
    Frames are signed with HMAC-SHA256 keyed from the WPA2 PMK of the Wi-Fi
    passphrase, and carry an NVS boot counter plus a sequence number so
    relays drop altered and replayed frames. After 20 s without Wi-Fi the
    node stops the core's back-to-back recon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
    [MeshFrame.h, MeshLink.cpp, MeshLink.h, MqttService.cpp, MqttService.h, MqttServiceTestStubs.cpp, MqttServiceTestSupport.h, NetworkConfig.cpp]
2026-10-23 Push node firmware from the dashboard and track node versions
    The hub now updates a sensor's firmware through the device's existing
    authenticated /api/ota, from a new Administration -> Firmware tab, and
    records every firmware version each node reports.
    - Staff pin each device's address and API token. The token is
    Fernet-sealed under CANARY_CARE_KEY and never returned. The address the
    node reports over MQTT is only a suggestion: the broker has no ACLs, so
    trusting it would let a forged status document redirect the token.
    - Uploads are checked for an ESP32 application image matching the node's
    chip, then streamed one node at a time. The answer is read while
    sending, so a device that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
    [HardwareConfig.h, NetworkConfig.cpp, NetworkConfig.h, StatusJson.cpp, StatusJson.h, air_sensor.ino]
2026-10-23 Show readings, connectivity and alerts on an SSD1306 OLED
    The air sensor drives an optional 128x64 SSD1306 on I2C (SDA GPIO8,
    SCL GPIO9, 0x3C) with U8g2. The top row shows Wi-Fi and the hub (MQTT)
    connection; below it are the readings with each channel's grade, the
    climate and presence, and the device's IP or the setup portal to join.
    A warning, danger, silenced alarm or self-test takes over the screen
    with the hazard, its value and the alarm state, blinking while it sounds.
    The display never touches the safety loop's timing: the loop only copies
    a small snapshot under a spinlock, and a low-priority task composes and
    draws it. A display that does not answer at boot is left off and the
    senso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
2026-10-26 Write Romanian incident briefs from the template
    The on-device 1.5B model writes garbled Romanian that misstates the
    incident facts, so Romanian briefs skip the LLM; English keeps it.
2026-10-26 Keep an incident open while any of its devices still reads a hazard
    The clear hold counted normal readings from any device of the incident,
    so a second sensor that joined and then read normal could close an
    evacuation whose source last reported an alarm and went silent. Now a
    device's clearing reading only counts once every other device's latest
    reading is clearing too.
2026-10-27 Explain false-alarm evidence and flag untrustworthy sensors
    Incidents get an advisory fusion panel: heuristic score, supporting and
    contradicting evidence, missing inputs, overrides and input age. Sensors
    get a trust state (ok/suspect/lost) for stale, stuck, noisy or shifted
    channels. Both are read-only, staff-only, and never touch alarm decisions.
2026-10-27 Show ESPectre Wi-Fi motion per room for staff
    Stock ESPectre 3.0.0 boards publish under espectre/v1/devices/<id>. A
    dedicated adapter, routed first in dispatch(), keeps each board's health
    and readiness and stores motion on state changes (unchanged states at
    most every 5 s), dropping duplicates and out-of-order messages within a
    boot. Motion is never a SensorType, reading or occupancy estimate.
    GET /buildings/{id}/motion (staff only) gives each zone motion, no
    recent motion, calibrating, unavailable or no presence sensor. The
    dashboard shows it as floor-plan chips (live only, hidden in replay) and
    a Motion card.
2026-10-27 Compare each room with its own frozen normal
    A per-(zone, metric) median/MAD reference over the 14 days ending
    yesterday, without incident windows or flagged readings, rebuilt by an
    hourly job under the processing lease only when missing, learning,
    seed-only or a week old, so drift is not absorbed. Hour-of-day buckets
    appear once there are 7 days of history.
    GET /buildings/{id}/zone-normal gives usual / higher / lower than usual
    / learning / no recent data with a heuristic score in MAD units. The
    dashboard shows it in a card. tools/baseline_seed.py writes labelled
    synthetic references for a demo hub; live data replaces them. Evidence
    only: thresholds and the alarm path are unchanged.
    Co-Au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
2026-10-27 List the units a water leak may reach
    During a water-leak incident, managers and dispatchers see the units
    below the leaking unit (followed down up to 6 floors) and the units on a
    shared riser. The plumbing comes from an explicit topology file
    (CANARY_WATER_TOPOLOGY_FILE). A missing or unreadable file shows
    "unknown", never "none affected". No volume estimate, and the map never
    touches the incident or the valve.
2026-10-27 Add an evacuation what-if on a simulated floor graph
    Staff can mark corridors or stairs of a built-in simulated graph
    unavailable and see the recomputed shortest path from each room to an
    exit, the rooms left with no exit, and the busiest passages (people
    routed through / nominal capacity). It is stateless, never reads or
    writes EvacuationRoute rows or incidents, and every response and screen
    says "scenario — not a safety prediction".
2026-10-27 Show labelled room evidence and the observed sequence of an incident
    The fusion endpoint now lists evidence items from sensor trust, motion and
    room normals, each marked weak/normal and supporting/contradicting/context/
    missing. They are labels only: score and classification are unchanged, and
    motion is always weak context.
    GET /incidents/{id}/evidence-timeline replays stored readings, snapshots and
    motion observations: per-device first crossing, data gaps and out-of-order
    readings, with estimates kept apart. It never recomputes triangulation.
    Claude-Session: https://claude.ai/code/session_01X53tib9tQbZXcQW5jrN2HZ
2026-10-27 Size the MQ5 gas thresholds for the 15k/10k divider
    The reference build feeds the MQ5 output to GPIO10 through 15 kOhm / 10 kOhm,
    which passes 0.4 of AO (2.0 V at full scale). Lower the default gas
    thresholds to match (warn 1500 -> 1200, danger 2200 -> 1760, both x0.8),
    document the divider in the README, and add a script that draws the wiring
    diagram PDF from the pin map.
    Boards already configured through the portal keep their saved thresholds.
    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
2026-10-28 Read an external gas detector's relay contact on the air sensor
    The NC dry contact of a household gas detector is wired to GPIO11 (the
    ESP32-S3 has no GPIO25) with the internal pull-up. An open contact, from
    an alarm or a cut wire, reads as an alarm. Changes are accepted after
    200 ms stable; the boot state is taken as read. The state is reported as
    gas_detector.alarm in the status document, and each transition is logged
    and published over MQTT. Monitoring only: nothing drives the detector.
2026-10-28 Raise a gas incident from the air sensor's external detector contact
    Air nodes gain a gas_detector channel (combustible_gas, 1 = contact
    open). An open contact is a critical gas reading, so it evacuates like an
    MQ5 danger and joins any open gas incident; three closed readings clear
    it. Firmware without the field produces no reading. Nodes registered
    before the channel existed get its Device row once per hub process.
2026-10-28 Record labelled air sensor experiments without the hub
    Polls the sensor's /api/status directly and saves each raw status document
    with a baseline/event/recovery phase, so gas, fire and cooking runs can be
    replayed through the signature features for training.
2026-10-28 Update water sensor assembly
    [Water_sensor.SLDASM]
2026-11-01 Add labelled air sensor recordings
    Cooking, smoke, aerosol and natural gas runs from the experiment
    recorder. The aerosol run includes a device reboot shortly after the
    first spray; the cooking run shows no measurable response.
    [samples.csv]
2026-11-01 Shorten air sensor warm-up after a short power cut
    Sync the clock over SNTP (MQTT host first, pool.ntp.org second) and
    stamp the last-alive time to NVS every 10 s while it is set. When the
    next boot started under 30 s after that stamp, cap warm-up at 60 s
    instead of the configured window. Without a synced clock or a prior
    stamp the full warm-up applies. A short residual warm-up stays because
    the MQ5 and ZE03 read high after power returns and the PMS5003 fan
    needs about 30 s.
    [AirController.cpp, AirController.h, HardwareConfig.h, WarmupResume.h, air_sensor.ino, test_main.cpp]
2026-11-01 Train the signature model on labelled recordings
    Cut recorder runs into hub-shaped windows (15 s cadence, up to 600 s),
    mix them with the synthetic set and score by leaving one recording out
    at a time. Supports a random forest or a single decision tree, flags
    flat events and mid-run reboots, and writes a model only with --out.
2026-11-02 Rotate air sensor display 180 degrees
2026-11-02 Harden hub updates after review: interrupted rollouts, job errors, full peer health
    - An update or rollout interrupted by a crash or power cut ends as failed/stopped
    instead of blocking every later update.
    - An unexpected error in a job marks the Pi failed.
    - Peers report full health (containers, backend, Postgres member) through their
    updater; the coordinator's own step checks them too, and a rollout refuses while
    Patroni does not answer.
    - Peers confirm they know the commit (POST /check, fetching once if needed) before a
    rollout starts; GitHub's head comes from the Pi that fetched last.
2026-11-02 Beep once at startup on both sensors to verify the buzzer
    [HardwareConfig.h, air_sensor.ino, water_sensor.ino]
2026-11-02 Point sensors and docs at canary-hub.local
2026-11-02 Fix review findings: name collisions, app following a failover, opt-in announcing
    - announcer: treat avahi-publish renaming itself (canary-hub-2.local) as a failed publish and retry
    - announcer: only announce with CANARY_ANNOUNCE=1, which pi_setup.sh writes on Raspberry Pis
    - app: rebuild the live socket when the hub address changes; the socket asks for a search
    - app: keep asking for a search after a search that found nothing
    - app: open with the saved hub address and confirm it in the background
2026-11-03 Sensors fall back to canary-hub.local when the saved hub is unreachable
    A sensor set up with the hub's old fixed address could not reach it from the hotspot's
    subnet. When the saved MQTT host cannot be reached, the next attempt now looks up
    canary-hub.local over mDNS, then the saved host again, alternately (HubHost.h, shared by
    both firmwares). ".local" hosts are resolved with MDNS.queryHost on the network task, so
    canary-hub.local also works as the saved host. A refused login does not switch hosts.
    Firmware 1.2.0.
    [HardwareConfig.h, HubHost.h, MqttService.cpp, MqttService.h, MqttServiceTestStubs.cpp]
2026-11-03 Answer canary-hub.local from the hotspot address
    avahi answers from the interface's first address, the fixed cluster address, and the ESP32
    mDNS client drops answers from outside its subnet: sensors asked for canary-hub.local and
    never accepted the reply. The announcer now also answers A/ANY questions for the name itself,
    sending from the hotspot address, while this Pi announces. avahi keeps publishing the same
    record, so name conflicts are still detected.
2026-11-04 Lost sensors stay visible in Real mode; stale node list confirmed
2026-11-04 feat(backend): demo incidents sound the real buzzers and close the valve
    The first entry of a Demo building incident into an alarmed state sends TEST to the online
    air nodes and CLOSE to the online water nodes of the Real building. The decision is taken in
    the transition; the commands go out after the incident's commit from a background task with
    its own session, since commands.send commits. Failures are logged, never raised.
2026-11-04 fix(backend): demo mirror sends commands only in demo mode
    In Real mode a stray Demo building incident must not close the real valve. The mode is read at
    send time in the background task's own session; if the read fails, nothing is sent.
2026-11-04 Relay live MQTT messages to the broker behind the floating IP
    A sensor keeps its broker for as long as the connection lasts, so after a
    hotspot drop it can stay on a Pi that no longer holds the VIP, publishing where
    no backend reads it. It looks healthy and the hub shows it offline.
    A Mosquitto bridge would fix that and raise false incidents: on every reconnect
    it hands old retained messages to subscribers as live ones, whatever its
    settings (tested on 2.1.2). The relay subscribes like any client, where a stored
    message arrives with the retain flag set, and forwards only live ones. A marker
    on forwarded messages stops a loop if two relays disagree about the VIP.
    It uses the backend image b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
2026-11-04 Make the external gas detector optional per sensor
2026-11-11 Redesign the operations dashboard as a quiet two-theme console
    The web dashboard gets a new visual system and app shell: a left rail
    with the Dispatch incident count, a utility bar with Demo/Real,
    language and a new dark/light theme switch, and every colour moved
    into tokens so charts and the floor plan follow the theme. Inter is
    bundled so the hub renders it offline.
    Colour now means state only: ungraded facts render in plain text,
    chart series use a blue-to-slate ramp separated by dash pattern, and
    the Demo badge is a neutral outline.
    Long repeated lists become compact matrices and grouped lines:
    Device health, room baselines, motion, fusion evidence and occupied
    zones, all keeping every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
2026-11-12 Find the hub from the web build of the resident app
    The /health probe used dart:io's HttpClient, which does not exist in a
    browser, so every probe failed silently and the web build stayed on
    "looking for hub". Probe with dio instead, which works on web and phones.
2026-11-12 Redesign the resident app in the console's design system
    The phone app now uses the dashboard's Quiet Console tokens in light and
    dark (following the phone's setting), with Inter bundled. Residents get
    bottom tabs (Home / Household / Settings); Home is a status block, a
    one-line emergency-profile row and two-column room cards. Alarm and
    evacuation screens keep their loud banner language: fill by state, hazard
    tape on evacuation, signs on white discs, a darker advice band and a fixed
    check-in bar. State is shown by shape-coded marks as well as colour, labels
    are sentence case, and Romanian text wraps without truncation.
    Tests that asserted the old look (uppercase labels, dark by default) are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
